chGoodchild/NewTokenSystem/docs/token_system_bills_gimpedE001.jpg

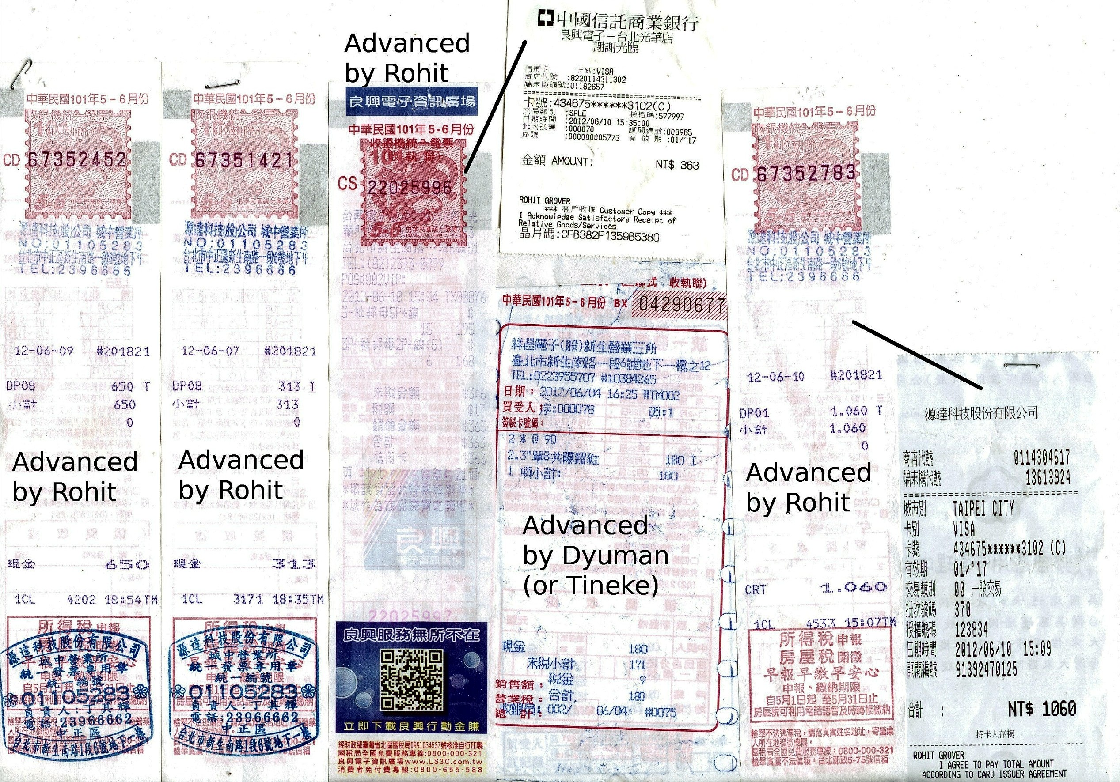
docs/token_system_bills_gimpedE001.jpg
