chGoodchild/NewTokenSystem/README.md

NewTokenSystem
==============

This readme tells talks about the purpose of the token sysem and what it's intensions were, it is a part of my resume so it was not written for these purposes..
https://docs.google.com/document/d/1ylsPUMJ8gZvrLt9GusnUoT-MT-kBT5VOH7maTBeV-WY/pub

NewTokenSystem
