chGoodchild/NewTokenSystem/datasheets/code.jpg

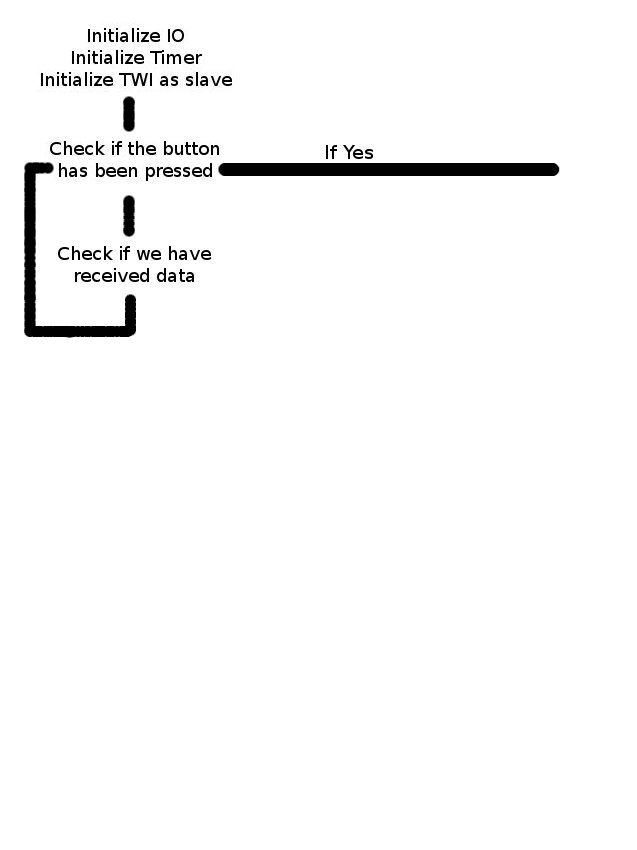
datasheets/code.jpg
