chGoodchild/NewTokenSystem/(commit log)

2012-02-13 checking in the updated board I got from Dyuman
    [main_board.brd, main_board.sch, single_digit.brd, single_digit.sch]
2012-02-13 added the corrected schematic from Dyuman :)
2012-02-22 This is my automated commit message (like a make file)...
    [Chandran-MainBoard.sch, Dyuman-TokenCounter.sch, main_board.brd, main_board.sch, purchase.ods]
2012-06-26 Small change in the flow chart, and improvement in the doccumentation
2012-07-04 Added bill spreadsheet and scan of some bills
    [bills_to_get_money_back_28-06-12.ods]
2012-07-04 Updated the date in the filename of bills_to_get_money_back_04-07-12.ods
    [bills_to_get_money_back_04-07-12.ods]
2012-11-03 Fixed DIP-switch error, still needs to be tested
    [counter.c]
2012-12-26 Up to date files, and corrected syntax error in _delay_ms
    [counter.c]
2013-01-19 first cut at the I2C snoop firmware; this is a blink copy of counter
2013-01-19 increasing the buffer size of I2C library
2013-01-19 First cut for the I2C snooper; this version simply dumps something on the uart.
2013-01-19 connect the I2C read with sendUart()
2013-01-20 enabling collision detection for I2C transfers
    [USI_TWI_Master.h]
2013-01-20 Expose TWI_MASTER's state to the application; this will help in identifying collisions.
    [USI_TWI_Master.c, USI_TWI_Master.h]
2013-01-20 Revert "Expose TWI_MASTER's state to the application; this will help in"
    This reverts commit f38bb8ee263d6bd5697c4ef344afab652451b3fc.
    There is already an API to get the master's error state.
    [USI_TWI_Master.c, USI_TWI_Master.h]
2013-01-20 moved sei() back into the interrupt handler for button press
2013-01-20 Detect multi-master data collision and report it as a failure.
    [USI_TWI_Master.c]
2013-01-20 Send out the lastToken with the commands in order to generate collisions.
    [counter.c]
2013-01-21 added some comments to explain collision handling
    [USI_TWI_Master.h, counter.c]
